MissouriMRDT/2019_Competition_Valkyrie/Documentation/ArmMotorController_Hardware_BOM.csv

Id | Designator | Package | Designation | Item Name | Part Number | Vendor | Quantity | Cost Per Item | Cost | URL | Comments
 | R40,R41R47,R10,R16,R15,R14,R13,R18,R19,R12,R20,R17,R9,R11,R29,R8,R23,R24,R26,R27,R25,R28,R30,R31,R32,R33,R34,R35,R22,R6,R5,R4,R2,R1,R3,R21,R7,R44,R45,R46,R48,R49,R50,R36,R37 | R_0603_1608Metric_Pad1.05x0.95mm_HandSolder | 500 | RES SMD 510 OHM 5% 1/4W 0603 | RHM510DCT-ND | Digikey | 46 | 0.1 |  | https://www.digikey.com/product-detail/en/rohm-semiconductor/ESR03EZPJ511/RHM510DCT-ND/1762937
 | U5,U7,U6,U8 | MultiPowerSO_30 | VNH5019A_E | IC MOTOR DRIVER PAR 30MULTIPWRSO | 497-13073-1-ND | Digikey | 4 | 8.3 |  | https://www.digikey.com/product-detail/en/stmicroelectronics/VNH5019ATR-E/497-13073-1-ND/3455763
 | U3 | TM4C129E_Launchpad_FULL_Bottom_SMD | TM4C129E_Launchpad | EVAL KIT TIVA C SERIES LAUNCHPAD | 296-37267-ND | Digikey | 1 | 20.76 |  | https://www.digikey.com/products/en?keywords=296-37267-ND
 | U3 | Header | TM4C129E_Launchpad | CONN HDR 20POS 0.1 TIN SMD | S5680-ND | Digikey | 4 | 2.13 |  | https://www.digikey.com/product-detail/en/sullins-connector-solutions/NPTC102KFMS-RC/S5680-ND/776139
 | D18,D19,D20,D21 | D_0603_1608Metric_Pad1.05x0.95mm_HandSolder | D_Schottky | DIODE SCHOTTKY 40V 200MA 0603 | 478-7798-1-ND | Digikey | 4 | 0.46 |  | https://www.digikey.com/product-detail/en/avx-corporation/SD0603S040S0R2/478-7798-1-ND/3749483
 | C12,C13,C11,C10 | C_0603_1608Metric_Pad1.05x0.95mm_HandSolder | .1uF | CAP CER 0.1UF 16V X7R 0603 | 1276-1005-1-ND | Digikey | 4 | 0.1 |  | https://www.digikey.com/product-detail/en/samsung-electro-mechanics/CL10B104KO8NNNC/1276-1005-1-ND/3889091
 | C5,C2,C6,C4,C9,C7,C8,C3 | C_0603_1608Metric_Pad1.05x0.95mm_HandSolder | 10u | CAP CER 10UF 6.3V X5R 0603 | 1276-1119-1-ND | Digikey | 8 | 0.15 |  | https://www.digikey.com/product-detail/en/samsung-electro-mechanics/CL10A106MQ8NNNC/1276-1119-1-ND/3889205
 | C1 | C_0603_1608Metric_Pad1.05x0.95mm_HandSolder | .1u | CAP CER 0.1UF 16V X7R 0603 | 1276-1005-1-ND | Digikey | 1 | 0.1 |  | https://www.digikey.com/product-detail/en/samsung-electro-mechanics/CL10B104KO8NNNC/1276-1005-1-ND/3889091
 | Conn3 | MOLEX_SL_02_Vertical | Limit_Switch | CONN HEADER 2POS .100 VERT GOLD | WM4800-ND | Digikey | 8 | 0.84 |  | https://www.digikey.com/products/en?keywords=WM4800-ND
 | Conn11 | MOLEX_SL_05_Vertical | Molex_SL_05 | CONN HDR VERT 5POS .100 TIN | WM4827-ND | Digikey | 1 | 1.11 |  | https://www.digikey.com/product-detail/en/molex-llc/0705430039/WM4827-ND/313742
 | Conn12,Conn13,Conn14,Conn15 | MOLEX_SL_03_Vertical | Encoder_1 | CONN HEADER 3POS .100 VERT GOLD | WM4801-ND | Digikey | 4 | 0.92 |  | https://www.digikey.com/products/en?keywords=WM4801-ND
 | SW1,SW2,SW3,SW4 | SW_SPST_TL3305A | SW_Push | SWITCH TACTILE SPST-NO 50MA 12V | EG5350CT-ND | Digikey | 4 | 0.2 |  | https://www.digikey.com/products/en?keywords=EG5350CT-ND
 | SW5 | SW_CuK_OS102011MA1QN1_SPDT_Angled | SW_SPDT | SWITCH SLIDE SPDT 100MA 12V | CKN9559-ND | Digikey | 1 | 0.4 |  | https://www.digikey.com/products/en?keywords=CKN9559
 | U1 | OKI | OKI | DC DC CONVERTER 3.3V 5W | 811-2692-ND | Digikey | 1 | 4.54 |  | https://www.digikey.com/product-detail/en/murata-power-solutions-inc/OKI-78SR-3.3-1.5-W36H-C/811-3014-ND/4878851
 | U2 | OKI | OKI | DC DC CONVERTER 5V 8W | 811-3014-ND | Digikey | 1 | 4.54 |  | https://www.digikey.com/product-detail/en/murata-power-solutions-inc/OKI-78SR-5-1.5-W36H-C/811-2692-ND/3438675
 | U4 | SOIC_16_3.9x9.9mm_Pitch1.27mm | MAX_3232 | IC DRVR/RCVR MULTCH RS232 16SOIC | 296-13094-1-ND | Digikey | 1 | 1.89 |  | https://www.digikey.com/product-detail/en/texas-instruments/MAX3232CDR/296-13094-1-ND/484464
 | R38,R39,R42,R43 | R_0603_1608Metric_Pad1.05x0.95mm_HandSolder | 800 | RES SMD 820 OHM 5% 1/4W 0603 | RHM820DCT-ND | Digikey | 4 | 0.1 |  | https://www.digikey.com/product-detail/en/rohm-semiconductor/ESR03EZPJ821/RHM820DCT-ND/4053825
 |  | Black Anderson Housing | Black Anderson Housing | Black Anderson Housing | 1327G6 | Powerwerx | 1 | 0.37 |  | https://powerwerx.com/anderson-powerpole-colored-housings
 |  | Yellow Anderson Housing | Yellow Anderson Housing | Yellow Anderson Housing | 1327G16 | Powerwerx | 1 | 0.39 |  | https://powerwerx.com/anderson-powerpole-colored-housings
 |  | Red Anderson Housing | Red Anderson Housing | Red Anderson Housing | 1327 | Powerwerx | 1 | 0.37 |  | https://powerwerx.com/anderson-powerpole-colored-housings
 |  | White Anderson Housing | White Anderson Housing | White Anderson Housing | 1327G7 | Powerwerx | 4 | 0.39 |  | https://powerwerx.com/anderson-powerpole-colored-housings
 |  | Misc. Anderson Housing | Misc. Anderson Housing | Misc. Anderson Housing |  | Powerwerx | 4 | 0.39 |  | https://powerwerx.com/anderson-powerpole-colored-housings | There will be a white anderson housing on each motor anderson OUTB, and then a different color for each OutA
 |  | PCB Horizontal Bottom Contact | PCB Horizontal Bottom Contact | PCB Horizontal Bottom Contact | 1336G1 | Powerwerx | 11 | 0.53 |  | https://powerwerx.com/anderson-1336g1-printed-circuit-board-horizontal
 | D22,D9,D10,D11,D12,D13,D14 | Yellow LED |  | LED YELLOW CLEAR SMD | 160-1448-1-ND | Digikey | 7 | 0.31 |  | https://www.digikey.com/product-detail/en/lite-on-inc/LTST-C191KSKT/160-1448-1-ND/386838
 | D5,D6,D7,D8 | Orange LED |  | LED ORANGE CLEAR SMD | 160-1445-1-ND | Digikey | 4 | 0.27 |  | https://www.digikey.com/product-detail/en/lite-on-inc/LTST-C191KFKT/160-1445-1-ND/386832
 | D17 | Red LED |  | LED RED CLEAR SMD | 160-1447-1-ND | Digikey | 1 | 0.29 |  | https://www.digikey.com/product-detail/en/lite-on-inc/LTST-C191KRKT/160-1447-1-ND/386836
 | D1,D4,D23 | Green LED |  | LED GREEN CLEAR SMD | 160-1446-1-ND | Digikey | 3 | 0.29 |  | https://www.digikey.com/product-detail/en/lite-on-inc/LTST-C191KGKT/160-1446-1-ND/386834
 | D15,D16 | Blue LED |  | LED BLUE CLEAR CHIP SMD | 160-1647-1-ND | Digikey | 2 | 0.53 |  | https://www.digikey.com/product-detail/en/lite-on-inc/LTST-C191TBKT/160-1647-1-ND/573587
