MissouriMRDT/2019_Competition_Valkyrie/ArmDriveboard_Hardware/3D Files/ArmDriveBoard_Hardware-Edge.Cuts.dxf

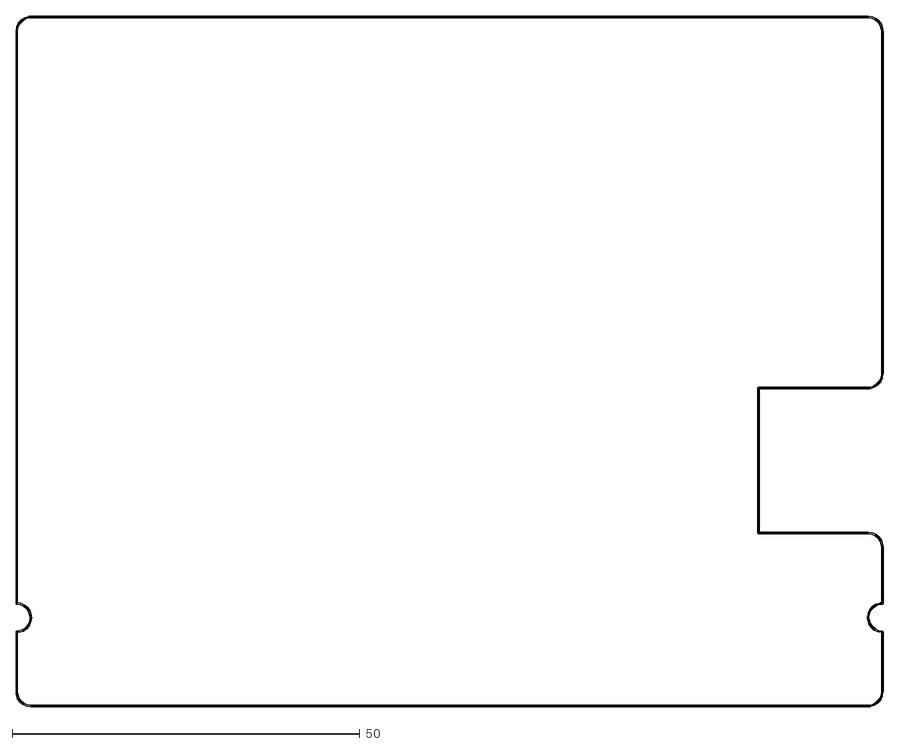
[picture p1: CAD file, 2019-08-25]
ArmDriveboard_Hardware/3D Files/ArmDriveBoard_Hardware-Edge.Cuts.dxf
124.7 x 99.3
