MissouriMRDT/2019_Competition_Valkyrie/ArmMotorController_Hardware/3D Files/ArmMotorController_Hardware-B.Cu.dxf

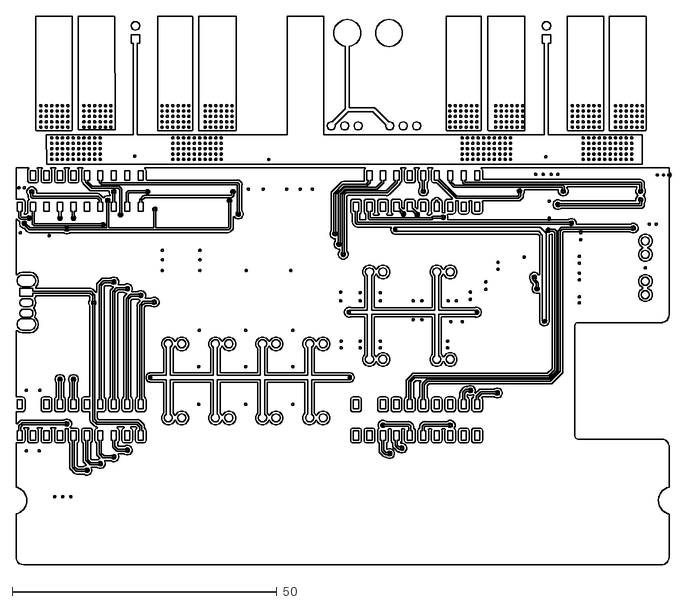
[picture p2: CAD file, 2019-08-25]
ArmMotorController_Hardware/3D Files/ArmMotorController_Hardware-B.Cu.dxf
123.6 x 103.6
