MissouriMRDT/2019_Competition_Valkyrie/ArmDriveboard_Hardware/3D Files/ArmDriveBoard_Hardware-F.Cu.dxf

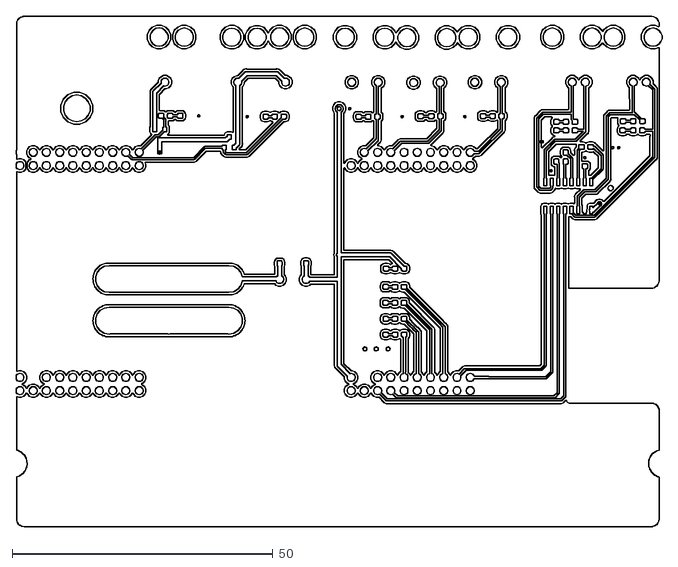
[picture p3: CAD file, 2019-08-25]
ArmDriveboard_Hardware/3D Files/ArmDriveBoard_Hardware-F.Cu.dxf
123.9 x 97.8
