MissouriMRDT/2019_Competition_Valkyrie/ArmMotorController_Hardware/3D Files/ArmMotorController_Hardware-F.Cu.dxf

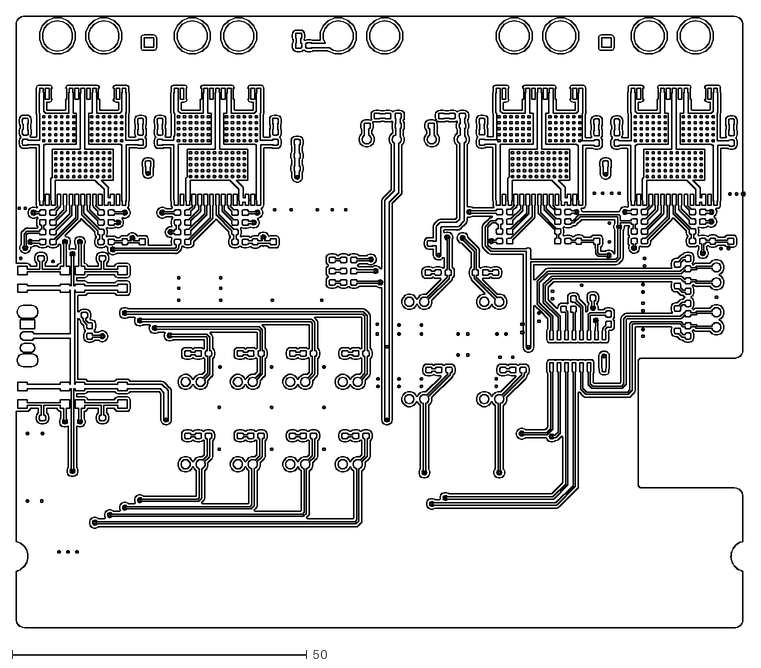
[picture p4: CAD file, 2019-08-25]
ArmMotorController_Hardware/3D Files/ArmMotorController_Hardware-F.Cu.dxf
123.6 x 103.7
