MissouriMRDT/2019_Competition_Valkyrie/ArmDriveboard_Hardware/3D Files/ArmDriveBoard_Hardware-B.Cu.dxf

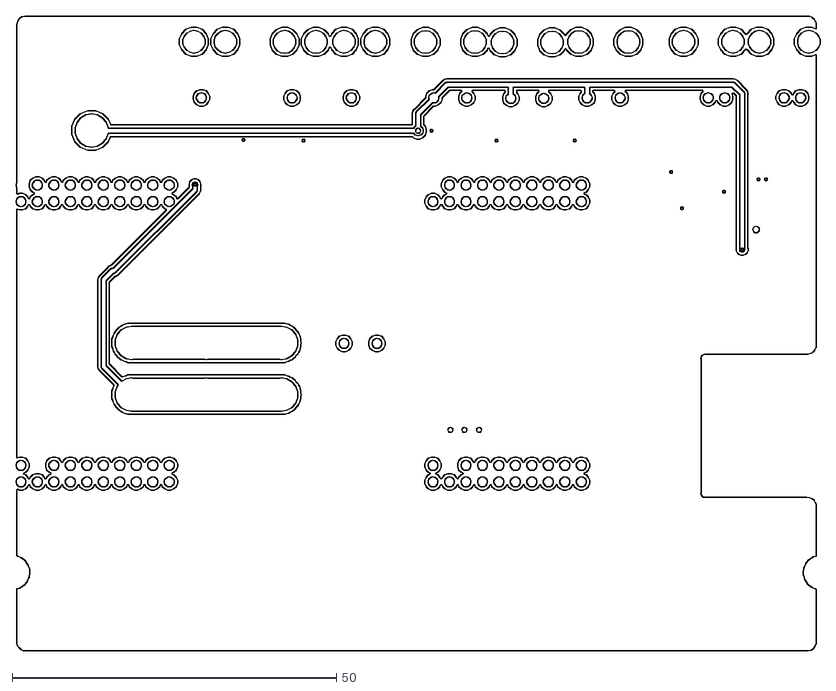
[picture p5: CAD file, 2019-08-25]
ArmDriveboard_Hardware/3D Files/ArmDriveBoard_Hardware-B.Cu.dxf
123.9 x 97.8
