MissouriMRDT/2019_Competition_Valkyrie/ArmMotorController_Hardware/3D Files/ArmMotorController_Hardware-Edge.Cuts.dxf

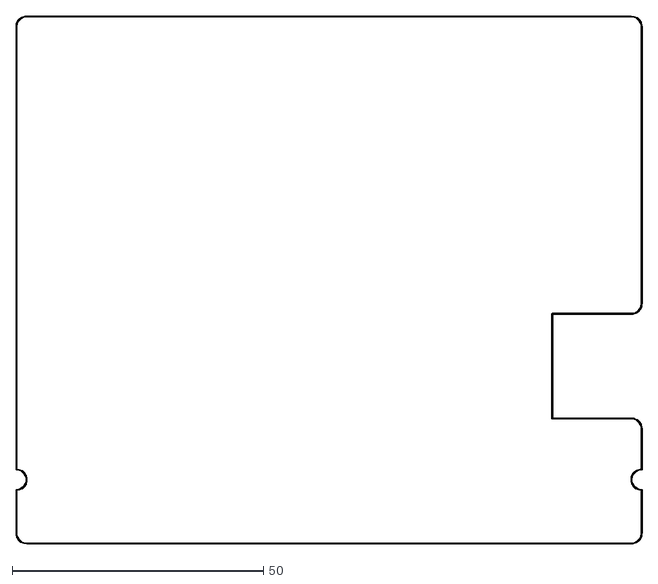
[picture p6: CAD file, 2019-08-25]
ArmMotorController_Hardware/3D Files/ArmMotorController_Hardware-Edge.Cuts.dxf
124.6 x 105.1
