MissouriMRDT/2019_Competition_Valkyrie/ArmDriveboard_Hardware/3D Files/0.1.stp

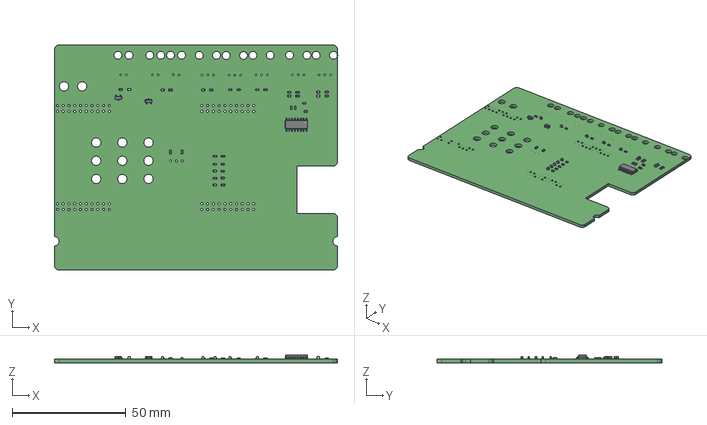
[picture p7: CAD file, 2019-08-25]
ArmDriveboard_Hardware/3D Files/0.1.stp
124.5 x 99.1 x 3.40 mm
