MissouriMRDT/2019_Competition_Valkyrie/ArmMotorController_Hardware/3D Files/ArmMotorController_Hardware.step

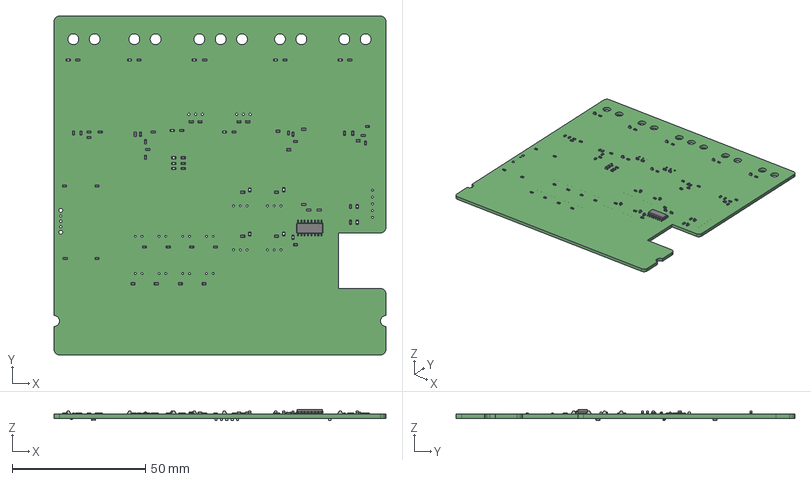
[picture p8: CAD file, 2019-08-25]
ArmMotorController_Hardware/3D Files/ArmMotorController_Hardware.step
124.5 x 127.0 x 4.25 mm
