MissouriMRDT/2019_Competition_Valkyrie/(list of files, cad)

Other CAD files:
ArmDriveboard_Hardware/3D Files/ArmDriveBoard_Hardware-B.Mask.dxf
ArmDriveboard_Hardware/3D Files/ArmDriveBoard_Hardware-B.Paste.dxf
ArmDriveboard_Hardware/3D Files/ArmDriveBoard_Hardware-B.SilkS.dxf
ArmDriveboard_Hardware/3D Files/ArmDriveBoard_Hardware-F.Mask.dxf
ArmDriveboard_Hardware/3D Files/ArmDriveBoard_Hardware-F.Paste.dxf
ArmMotorController_Hardware/3D Files/ArmMotorController_Hardware-B.Mask.dxf
ArmMotorController_Hardware/3D Files/ArmMotorController_Hardware-B.Paste.dxf
ArmMotorController_Hardware/3D Files/ArmMotorController_Hardware-B.SilkS.dxf
ArmMotorController_Hardware/3D Files/ArmMotorController_Hardware-F.Mask.dxf
ArmMotorController_Hardware/3D Files/ArmMotorController_Hardware-F.Paste.dxf
