MissouriMRDT/2019_Competition_Valkyrie/ArmMotorController_Hardware/ArmMotorController_Hardware.kicad_pcb

## KiCad design ArmMotorController_Hardware/ArmMotorController_Hardware.kicad_pcb (2019-08-25)

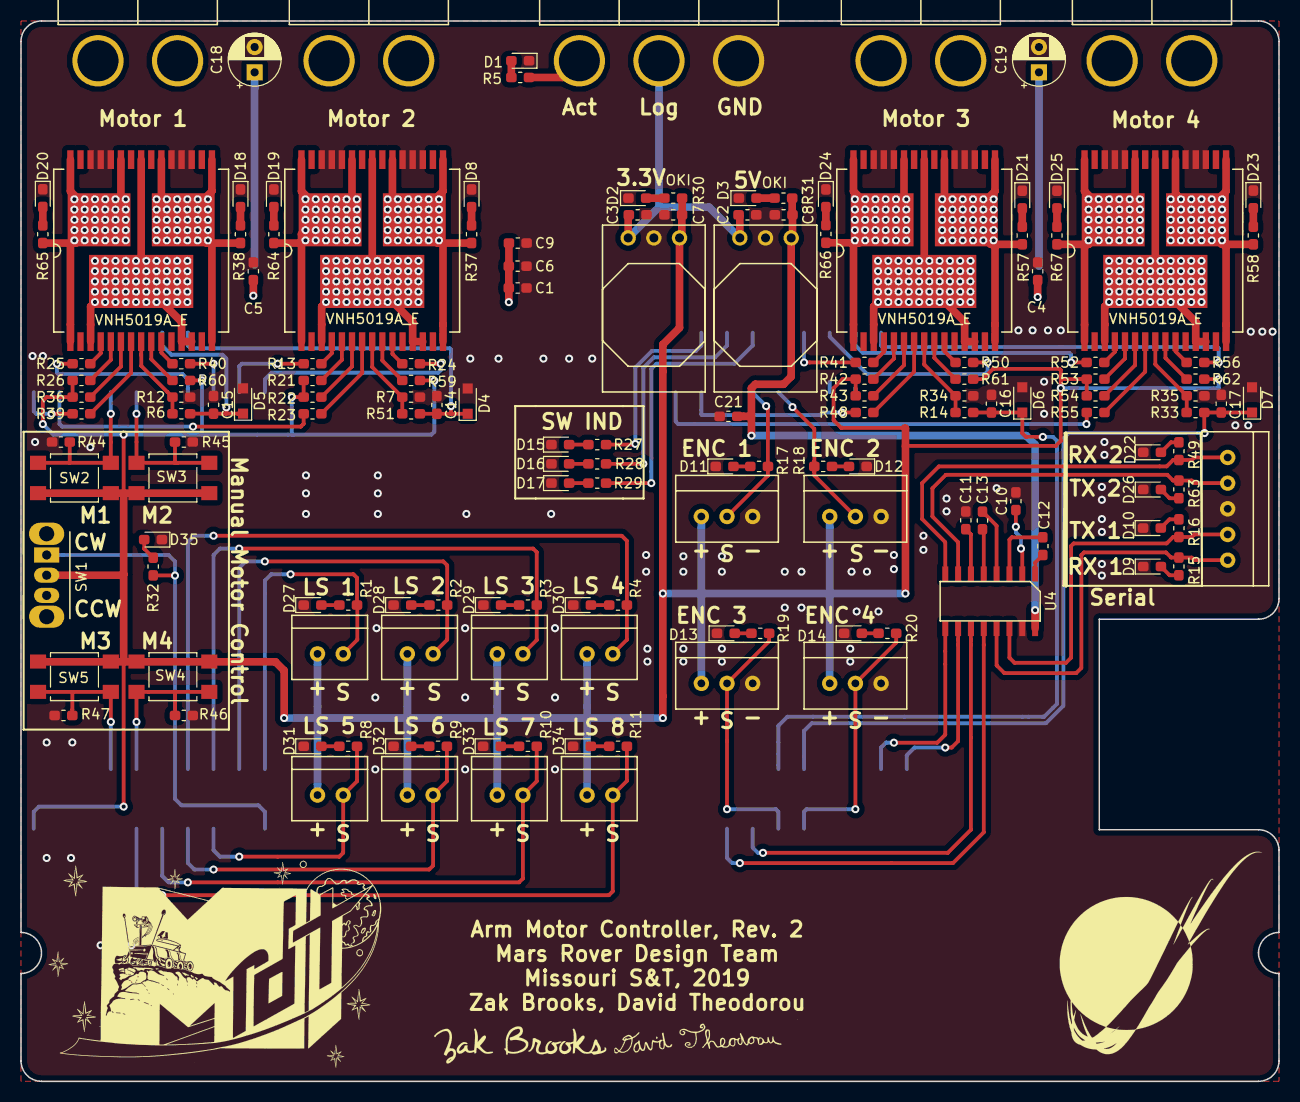
[picture p9: board ArmMotorController_Hardware.kicad_pcb from above]

Board: 2 copper layers, 124.5 x 104.9 mm, 153 parts (0 on the bottom side), 122 nets.

Parts:
C1, C10, C11, C12, C13: .1u; C_0603_1608Metric_Pad1.05x0.95mm_HandSolder
C2, C3, C4, C5, C6, C7, C8, C9: 10u; C_0603_1608Metric_Pad1.05x0.95mm_HandSolder
C14, C15, C16, C17: 33nF; C_0603_1608Metric_Pad1.05x0.95mm_HandSolder
C18, C19: 47u; CP_Radial_D5.0mm_P2.50mm
C21: 10uF; C_0603_1608Metric_Pad1.05x0.95mm_HandSolder
Conn1: Anderson-3; Anderson_3_Horizontal_Side_by_Side
Conn3: Limit_Switch_1; MOLEX_SL_02_Vertical
Conn4: Limit_Switch_2; MOLEX_SL_02_Vertical
Conn5: Limit_Switch_3; MOLEX_SL_02_Vertical
Conn6: Limit_Switch_4; MOLEX_SL_02_Vertical
Conn7: Limit_Switch_5; MOLEX_SL_02_Vertical
Conn8: Limit_Switch_6; MOLEX_SL_02_Vertical
Conn9: Limit_Switch_7; MOLEX_SL_02_Vertical
Conn10: Limit_Switch_8; MOLEX_SL_02_Vertical
Conn11: Molex_SL_05; MOLEX_SL_05_Vertical
Conn12: Encoder_1; MOLEX_SL_03_Vertical
Conn13: Encoder_2; MOLEX_SL_03_Vertical
Conn14: Encoder_3; MOLEX_SL_03_Vertical
Conn15: Encoder_4; MOLEX_SL_03_Vertical
Conn16, Conn17, Conn18, Conn19: AndersonPP; Anderson_2_Horizontal_Side_by_Side
D1, D2, D3, D8, D9, D10, D11, D12, D13, D14, D15, D16, D17, D18, D19, D20, D21, D22, D23, D24, D25, D26, D27, D28, D29, D30, D31, D32, D33, D34, D35: LED; LED_0603_1608Metric_Pad1.05x0.95mm_HandSolder
D4, D5, D6, D7: D_Zener; D_SOD-323_HandSoldering
R1, R2, R3, R4, R5, R8, R9, R10, R11, R15, R16, R17, R18, R19, R20, R27, R28, R29, R30, R31, R32, R44, R45, R46, R47, R49, R63: 500; R_0603_1608Metric_Pad1.05x0.95mm_HandSolder
R6, R14, R33, R51: 10k; R_0603_1608Metric_Pad1.05x0.95mm_HandSolder
R7, R12, R13, R21, R23, R24, R25, R26, R34, R35, R39, R40, R41, R42, R48, R50, R52, R53, R55, R56, R59, R60, R61, R62: 1k; R_0603_1608Metric_Pad1.05x0.95mm_HandSolder
R22, R36, R43, R54: 0; R_0603_1608Metric_Pad1.05x0.95mm_HandSolder
R37, R38, R57, R58, R64, R65, R66, R67: 1.5k; R_0603_1608Metric_Pad1.05x0.95mm_HandSolder
SW1: SW_SPDT; SW_CuK_OS102011MA1QN1_SPDT_Angled
SW2, SW3, SW4, SW5: SW_Push; SW_SPST_TL3305A
U1, U2: OKI; OKI_Horizontal
U3: TM4C129E_Launchpad; TM4C129E_Launchpad_FULL_SMD_BOTTOM
U4: MAX_3232; SOIC_16_3.9x9.9mm_Pitch1.27mm
U5, U6, U7, U8: VNH5019A_E; MultiPowerSO_30

Connections:
12vLog: C2.2, C3.2, Conn1.2, U1.1, U2.1
+3V3: C7.2, Conn3.1, Conn4.1, Conn5.1, Conn6.1, Conn7.1, Conn8.1, Conn9.1, Conn10.1, Conn12.1, Conn13.1, Conn14.1, Conn15.1, R21.2, R22.2, R26.2, R30.2, R36.2, R42.2, R43.2, R53.2, R54.2, R59.2, R60.2, R61.2, R62.2, SW1.2, SW2.1, SW3.1, SW4.1, SW5.1, U1.3, U3.+3V3
+5V: C8.2, C21.2, R31.2, U2.3, U4.16
+12V: C1.1, C4.1, C5.1, C6.1, C9.1, C18.1, C19.1, Conn1.3, R5.2, U5.3, U5.12, U5.13, U5.23, U5.32, U6.3, U6.12, U6.13, U6.23, U6.32, U7.3, U7.12, U7.13, U7.23, U7.32, U8.3, U8.12, U8.13, U8.23, U8.32
/Out_A_M1: Conn16.2, R65.2, U5.1, U5.25, U5.30, U5.31
/Out_A_M2: Conn17.2, R64.2, U6.1, U6.25, U6.30, U6.31
/Out_A_M3: Conn18.2, R66.2, U7.1, U7.25, U7.30, U7.31
/Out_A_M4: Conn19.2, R67.2, U8.1, U8.25, U8.30, U8.31
/Out_B_M1: Conn16.1, R38.2, U5.15, U5.16, U5.21, U5.33
/Out_B_M2: Conn17.1, R37.1, U6.15, U6.16, U6.21, U6.33
/Out_B_M3: Conn18.1, R57.1, U7.15, U7.16, U7.21, U7.33
/Out_B_M4: Conn19.1, R58.2, U8.15, U8.16, U8.21, U8.33
DIRECTION_SW: R32.1, SW1.1, U3.PB3
ENC_1_PWM: Conn12.2, R17.2, U3.PM0
ENC_2_PWM: Conn13.2, R18.2, U3.PM1
ENC_3_PWM: Conn14.2, R19.2, U3.PD4
ENC_4_PWM: Conn15.2, R20.2, U3.PD5
GND: C1.2, C2.1, C3.1, C4.2, C5.2, C6.2, C7.1, C8.1, C9.2, C10.2, C11.2, C14.2, C15.2, C16.2, C17.2, C18.2, C19.2, C21.1, Conn1.1, Conn11.3, Conn12.3, Conn13.3, Conn14.3, Conn15.3, D1.1, D2.1, D3.1, D4.2, D5.2, D6.2, D7.2, D8.1, D9.1, D10.1, D11.1, D12.1, D13.1, D14.1, D15.1, D16.1, D17.1, D18.1, D19.1, D20.1, D21.1, D22.1, D23.1, D24.1, D25.1, D26.1, D27.1, D28.1, D29.1, D30.1, D31.1, D32.1, D33.1, D34.1, D35.1, R7.1, R12.1, R34.1, R35.1, R44.1, R45.1, R46.1, R47.1, U1.2, U2.2, U3.GND, U4.15, U5.18, U5.19, U5.20, U5.26, U5.27, U5.28, U6.18, U6.19, U6.20, U6.26, U6.27, U6.28, U7.18, U7.19, U7.20, U7.26, U7.27, U7.28, U8.18, U8.19, U8.20, U8.26, U8.27, U8.28
IN_A1: R25.2, U3.PL0
IN_A2: R13.2, U3.PL2
IN_A3: R41.2, U3.PQ2
IN_A4: R52.2, U3.PP3
IN_B1: R40.2, U3.PL1
IN_B2: R24.2, U3.PL3
IN_B3: R50.2, U3.PQ3
IN_B4: R56.2, U3.PQ1
I_SENSE_1: C15.1, D5.1, R6.1, U3.PD1
I_SENSE_2: C14.1, D4.1, R51.1, U3.PD0
I_SENSE_3: C16.1, D6.1, R14.1, U3.PK0
I_SENSE_4: C17.1, D7.1, R33.1, U3.PK1
LED_IND_SW_1: R27.2, U3.PM7
LED_IND_SW_2: R28.2, U3.PP5
LED_IND_SW_ERR: R29.2, U3.PA7
LS_1: Conn3.2, R1.2, U3.PM5
LS_2: Conn4.2, R2.2, U3.PM4
LS_3: Conn5.2, R3.2, U3.PA6
LS_4: Conn6.2, R4.2, U3.PD7
LS_5: Conn7.2, R8.2, U3.PC7
LS_6: Conn8.2, R9.2, U3.PD3
LS_7: Conn9.2, R10.2, U3.PE5
LS_8: Conn10.2, R11.2, U3.PC6
M1_PWM: R39.2, U3.PF1
M1_SW: R44.2, SW2.2, U3.PG0
M2_PWM: R23.2, U3.PF2
M2_SW: R45.2, SW3.2, U3.PL4
M3_PWM: R48.2, U3.PK4
M3_SW: R47.2, SW5.2, U3.PE1
M4_PWM: R55.2, U3.PG1
M4_SW: R46.2, SW4.2, U3.PE2
unnamed: C10.1, U4.2
unnamed: C11.1, U4.6
unnamed: C12.1, U4.1
unnamed: C12.2, U4.3
unnamed: C13.1, U4.4
unnamed: C13.2, U4.5
unnamed: D1.2, R5.1
unnamed: D2.2, R30.1
unnamed: D3.2, R31.1
unnamed: D8.2, R37.2
unnamed: D9.2, R15.1
unnamed: D10.2, R16.1
unnamed: D11.2, R17.1
unnamed: D12.2, R18.1
unnamed: D13.2, R19.1
unnamed: D14.2, R20.1
unnamed: D15.2, R27.1
unnamed: D16.2, R28.1
unnamed: D17.2, R29.1
unnamed: D18.2, R38.1
unnamed: D19.2, R64.1
unnamed: D20.2, R65.1
unnamed: D21.2, R57.2
unnamed: D22.2, R49.1
unnamed: D23.2, R58.1
unnamed: D24.2, R66.1
unnamed: D25.2, R67.1
unnamed: D26.2, R63.1
unnamed: D27.2, R1.1
unnamed: D28.2, R2.1
unnamed: D29.2, R3.1
unnamed: D30.2, R4.1
unnamed: D31.2, R8.1
unnamed: D32.2, R9.1
unnamed: D33.2, R10.1
unnamed: D34.2, R11.1
unnamed: D35.2, R32.2
unnamed: R6.2, R12.2, U5.8
unnamed: R13.1, U6.4
unnamed: R14.2, R34.2, U7.8
unnamed: R21.1, U6.5
unnamed: R22.1, U6.6
unnamed: R23.1, U6.7
unnamed: R24.1, U6.10
unnamed: R25.1, U5.4
unnamed: R26.1, U5.5
unnamed: R33.2, R35.2, U8.8
unnamed: R36.1, U5.6
unnamed: R39.1, U5.7
unnamed: R40.1, U5.10
unnamed: R41.1, U7.4
unnamed: R42.1, U7.5
unnamed: R43.1, U7.6
unnamed: R48.1, U7.7
unnamed: R50.1, U7.10
unnamed: R7.2, R51.2, U6.8
unnamed: R52.1, U8.4
unnamed: R53.1, U8.5
unnamed: R54.1, U8.6
unnamed: R55.1, U8.7
unnamed: R56.1, U8.10
unnamed: R59.1, U6.9
unnamed: R60.1, U5.9
unnamed: R61.1, U7.9
unnamed: R62.1, U8.9
RX_1_SL: Conn11.5, R15.2, U4.13
RX_1_Tiva: U3.PP0, U4.12
RX_2_SL: Conn11.1, R49.2, U4.8
RX_2_Tiva: U3.PA4, U4.9
TX_1_SL: Conn11.4, R16.2, U4.14
TX_1_Tiva: U3.PP1, U4.11
TX_2_SL: Conn11.2, R63.2, U4.7
TX_2_Tiva: U3.PA5, U4.10
