MissouriMRDT/2019_Competition_Valkyrie/ArmDriveboard_Hardware/ArmDriveBoard_Hardware.kicad_pcb

## KiCad design ArmDriveboard_Hardware/ArmDriveBoard_Hardware.kicad_pcb (2019-08-25)

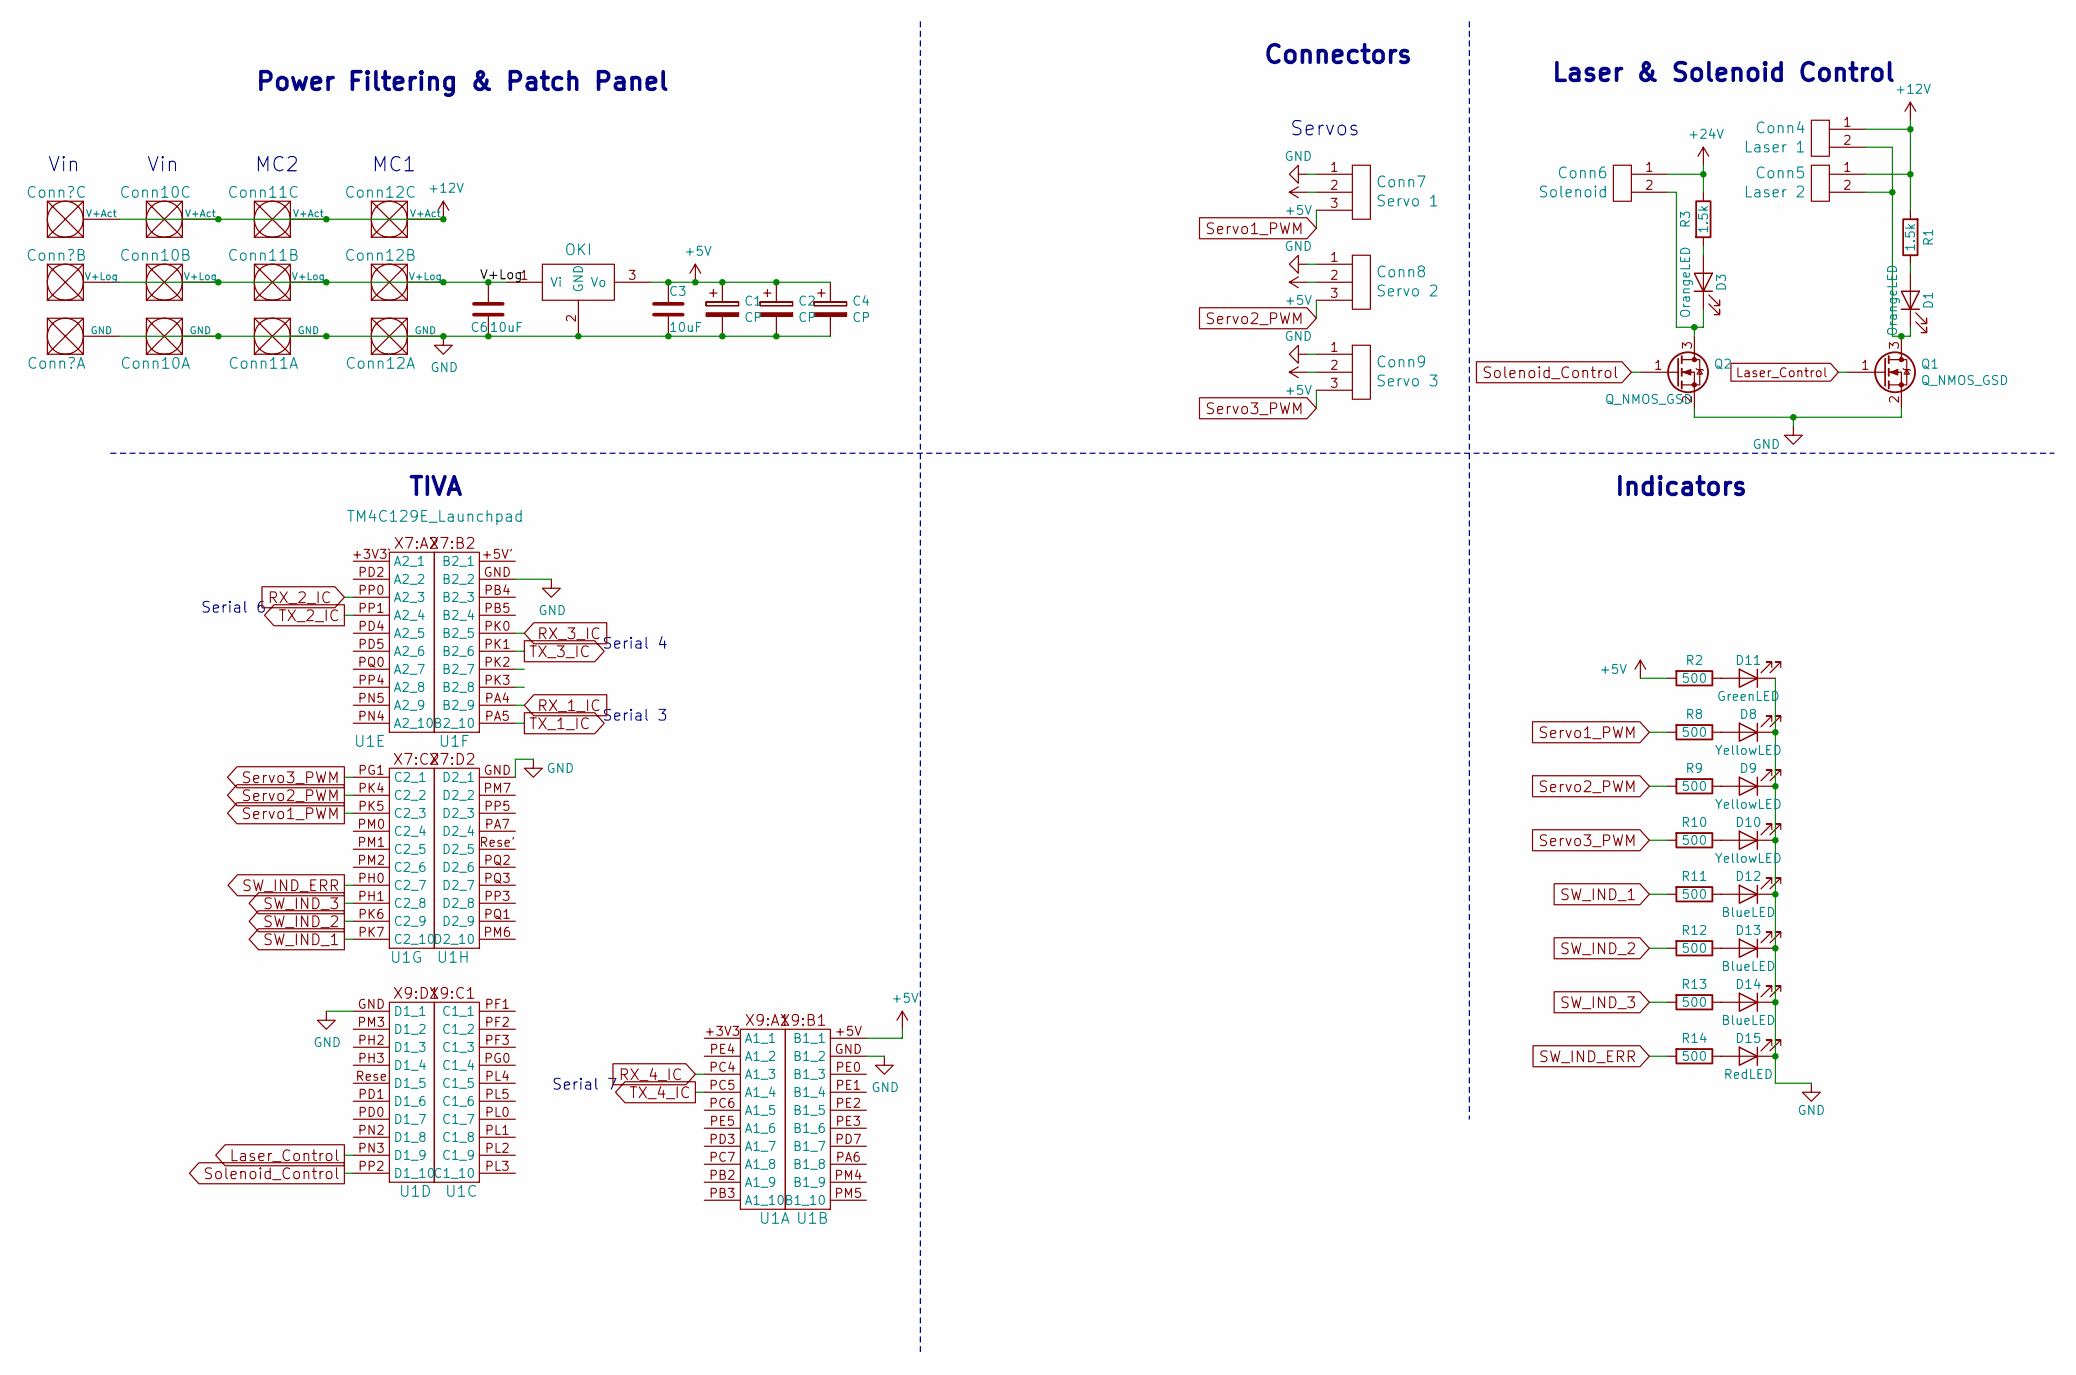
[picture p10: schematic ArmDriveBoard_Hardware.sch]

Parts:
C1, C2, C4: CP; CP_Radial_D8.0mm_P3.50mm
C3, C6: 10uF; C_0603_1608Metric_Pad1.05x0.95mm_HandSolder
Conn4: Laser 1; MOLEX_SL_02_Vertical
Conn5: Laser 2; MOLEX_SL_02_Vertical
Conn6: Solenoid; MOLEX_SL_02_Vertical
Conn7: Servo 1; MOLEX_SL_03_Vertical
Conn8: Servo 2; MOLEX_SL_03_Vertical
Conn9: Servo 3; MOLEX_SL_03_Vertical
Conn10, Conn11, Conn12: AndersonPP; Anderson_3_Vertical_Side_by_Side
D1, D3: OrangeLED; LED_0603_1608Metric_Pad1.05x0.95mm_HandSolder
D8, D9, D10: YellowLED; LED_0603_1608Metric_Pad1.05x0.95mm_HandSolder
D11: GreenLED; LED_0603_1608Metric_Pad1.05x0.95mm_HandSolder
D12, D13, D14: BlueLED; LED_0603_1608Metric_Pad1.05x0.95mm_HandSolder
D15: RedLED; LED_0603_1608Metric_Pad1.05x0.95mm_HandSolder
Q1, Q2: Q_NMOS_GSD; SOT-23
R1, R3: 1.5k; R_0603_1608Metric_Pad1.05x0.95mm_HandSolder
R2, R8, R9, R10, R11, R12, R13, R14: 500; R_0603_1608Metric_Pad1.05x0.95mm_HandSolder
U1: TM4C129E_Launchpad; TM4C129E_Launchpad_FULL_THT_BOTTOM
U3: OKI; OKI_Horizontal

Connections:
+5V: C1.1, C2.1, C3.1, C4.1, Conn7.2, Conn8.2, Conn9.2, R2.2, U1.+5V (B1_1), U3.3 (Vo)
+12V: Conn4.1, Conn5.1, Conn10.3 (V+Act), Conn11.3 (V+Act), Conn12.3 (V+Act), R1.2; also elsewhere on the board
+24V: Conn6.1, R3.1
/V+Log: C6.2, Conn10.2 (V+Log), Conn11.2 (V+Log), Conn12.2 (V+Log), U3.1 (Vi); also elsewhere on the board
GND: C1.2, C2.2, C3.2, C4.2, C6.1, Conn7.1, Conn8.1, Conn9.1, Conn10.1 (GND), Conn11.1 (GND), Conn12.1 (GND), D8.1 (K), D9.1 (K), D10.1 (K), D11.1 (K), D12.1 (K), D13.1 (K), D14.1 (K), D15.1 (K), Q1.2 (S), Q2.2 (S), U1.GND (B1_2), U3.2 (GND); also elsewhere on the board
Laser_Control: Q1.1 (G), U1.PN3 (D1_9)
unnamed: Conn4.2, Conn5.2, D1.1 (K), Q1.3 (D)
unnamed: Conn6.2, D3.1 (K), Q2.3 (D)
unnamed: D1.2 (A), R1.1
unnamed: D3.2 (A), R3.2
unnamed: D8.2 (A), R8.1
unnamed: D9.2 (A), R9.1
unnamed: D10.2 (A), R10.1
unnamed: D11.2 (A), R2.1
unnamed: D12.2 (A), R11.1
unnamed: D13.2 (A), R12.1
unnamed: D14.2 (A), R13.1
unnamed: D15.2 (A), R14.1
RX_1_IC: U1.PA4 (B2_9)
RX_2_IC: U1.PP0 (A2_3)
RX_3_IC: U1.PK0 (B2_5)
RX_4_IC: U1.PC4 (A1_3)
SW_IND_1: R11.2, U1.PK7 (C2_10)
SW_IND_2: R12.2, U1.PK6 (C2_9)
SW_IND_3: R13.2, U1.PH1 (C2_8)
SW_IND_ERR: R14.2, U1.PH0 (C2_7)
Servo1_PWM: Conn7.3, R8.2, U1.PK5 (C2_3)
Servo2_PWM: Conn8.3, R9.2, U1.PK4 (C2_2)
Servo3_PWM: Conn9.3, R10.2, U1.PG1 (C2_1)
Solenoid_Control: Q2.1 (G), U1.PP2 (D1_10)
TX_1_IC: U1.PA5 (B2_10)
TX_2_IC: U1.PP1 (A2_4)
TX_3_IC: U1.PK1 (B2_6)
TX_4_IC: U1.PC5 (A1_4)

Notes on the sheet:
Serial 6
Serial 3
TIVA
Power Filtering & Patch Panel
Connectors
Laser & Solenoid Control
MC1
MC2
Vin
Servos
Indicators
Serial 4
Serial 7

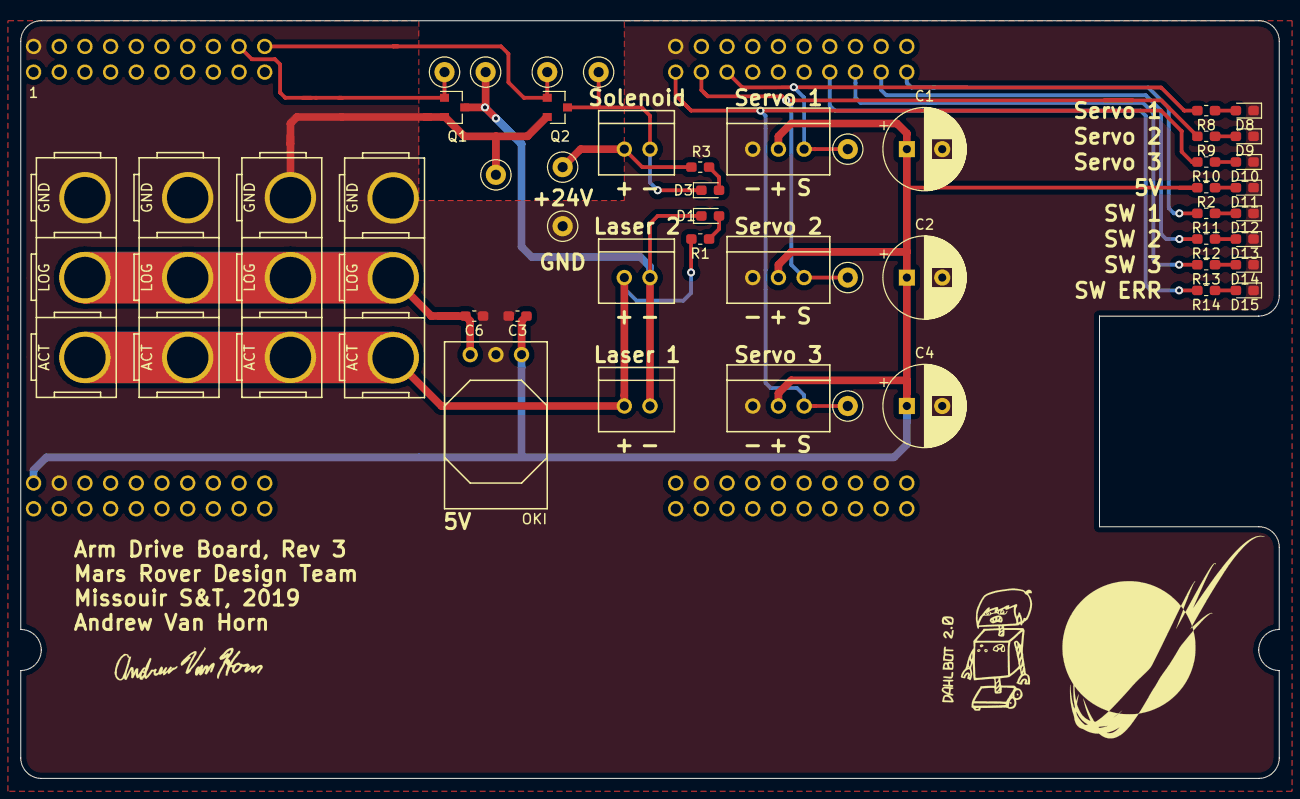
[picture p11: board ArmDriveBoard_Hardware.kicad_pcb from above]

Board: 2 copper layers, 124.5 x 74.9 mm, 39 parts (0 on the bottom side), 26 nets.

Other parts of the board:
Conn1: AndersonPP; Anderson_3_Vertical_Side_by_Side

Their connections:
+12V: Conn1.3; also elsewhere on the board
/V+Log: Conn1.2; also elsewhere on the board
GND: Conn1.1; also elsewhere on the board
